raquelfmcardoso/ambient-intelligence-2023-2024/(commit log)

2024-03-09 Added communication between Python script and Arduino Nano ESP32
2024-03-10 Added Arduino reading from Serial.
2024-03-11 Fixed error on read_serial.ino
    [read_serial.ino]
2024-03-15 Added ability to do a POST request to Ubidots. Fixed issues with read_test.
    [send_event.ino]
2024-03-16 Updated read_serial.ino with buzzer, post request and others. Missing leds
    [get_request.py, read_serial.ino]
2024-03-16 Fixed ifs to else ifs
    [read_serial.ino]
2024-03-17 Added LCD. Restructured camera detection.
2024-03-17 added leds
2024-03-17 Fixed bugs and set the time to start at the beginning of the minute.
    [get_request.py, read_serial.ino]
2024-03-17 Handled Cloud being down. Fixed checkInventory bug. Changed the way the messages are sent to the cloud.
    [read_serial.ino]
2024-03-17 Fixed one of the messages to send to the Cloud.
    [read_serial.ino]
2024-03-19 Fixed problems with medication detection.
    [camera_detection.ino]
2024-03-19 Refactored the project organisation: changed file names and directories. Changed device name in Ubidots. Deleted unnecessary files. Added a README.md
2024-03-19 Changed the number of leds and variable names.
2024-03-20 Refactored the code and added comments in smart_pill_organizer.ino. Changed the API token. Added instructions to the README.md for Nano ESP32.
2024-03-20 Fixed error with time on camera_detection.ino
    [camera_detection.ino]
2024-03-20 Added Assembly Instructions to README.md
2024-03-20 Added a new test file. Refined the existent one to be more accurate. Fixed an instruction in README.md.
    [ubidots_error_test.py, ubidots_exception_test.py]
2024-03-20 Fixed messages to be send to the email.
    [smart_pill_organizer.ino]
2024-03-20 Fixed interval in smart_pill_organized.ino
    [smart_pill_organizer.ino]
